eras/Blinds/Schematics/blinder.brd

## EAGLE design Schematics/blinder.brd (2012-12-26)

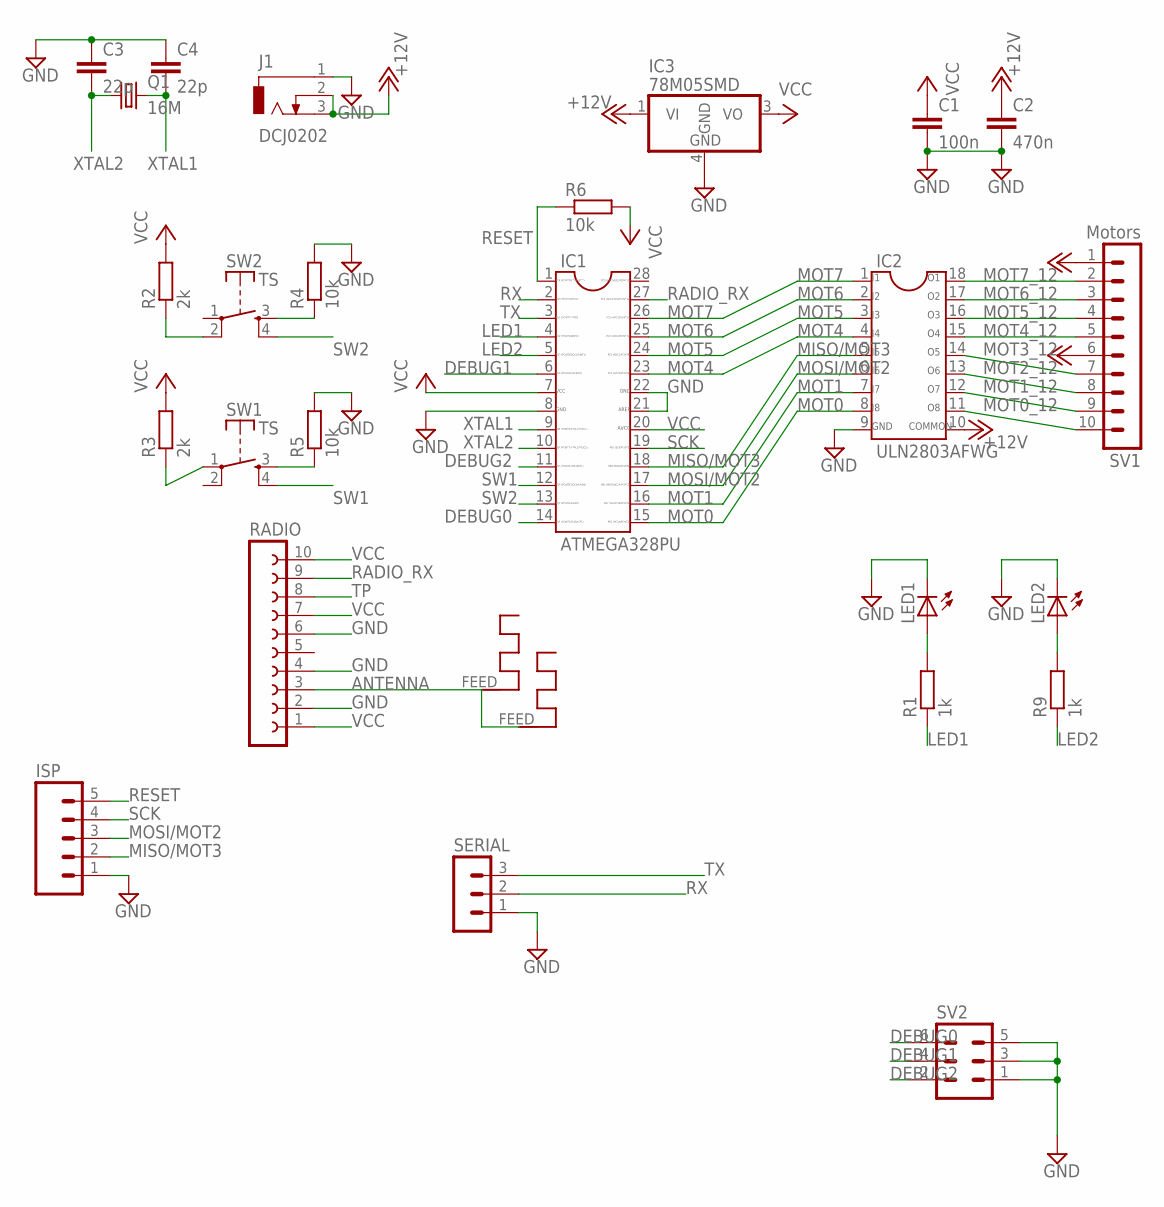
[picture p1: schematic blinder.sch]

Parts:
C1: 100n; C0805
C2: 470n; C0805
C3, C4: 22p; C0805
IC1: ATMEGA328PU; DIL28-3
IC2: ULN2803AFWG; DIL18
IC3: 78M05SMD; DPACK
ISP: M05LOCK; 1X05_LOCK
J1: DCJ0202
LED1, LED2: LED3MM
Q1: 16M; HC18U-V
R1, R9: 1k; R0805
R2, R3: 2k; R0805
R4, R5, R6: 10k; R0805
RADIO: FE10W
SERIAL: MA03-1
SV1: Motors; MA10-1W
SV2: MA03-2
SW1, SW2: TS
U$1, U$2: ANT44350H; DIPOLEHALF443.95_50

Connections:
+12V: C2.1, IC2.10 (COMMON), IC3.1 (VI), J1.2, J1.3, SV1.1, SV1.6
ANTENNA: RADIO.3, U$1.FEED, U$2.FEED
DEBUG0: IC1.14 (PB0), SV2.6
DEBUG1: IC1.6 (PD4), SV2.4
DEBUG2: IC1.11 (PD5), SV2.2
GND: C1.2, C2.2, C3.1, C4.1, IC1.8 (GND), IC1.21 (AREF), IC1.22 (GND2), IC2.9 (GND), IC3.4 (GND), ISP.1, J1.1, LED1.K (C), LED2.K (C), R4.2, R5.2, RADIO.2, RADIO.4, RADIO.6, SERIAL.1, SV2.1, SV2.3, SV2.5
LED1: IC1.4 (PD2), R1.1
LED2: IC1.5 (PD3), R9.1
MISO/MOT3: IC1.18 (PB4), IC2.5 (I5), ISP.2
MOSI/MOT2: IC1.17 (PB3), IC2.6 (I6), ISP.3
MOT0: IC1.15 (PB1), IC2.8 (I8)
MOT0_12: IC2.11 (O8), SV1.10
MOT1: IC1.16 (PB2), IC2.7 (I7)
MOT1_12: IC2.12 (O7), SV1.9
MOT2_12: IC2.13 (O6), SV1.8
MOT3_12: IC2.14 (O5), SV1.7
MOT4: IC1.23 (PC0), IC2.4 (I4)
MOT4_12: IC2.15 (O4), SV1.5
MOT5: IC1.24 (PC1), IC2.3 (I3)
MOT5_12: IC2.16 (O3), SV1.4
MOT6: IC1.25 (PC2), IC2.2 (I2)
MOT6_12: IC2.17 (O2), SV1.3
MOT7: IC1.26 (PC3), IC2.1 (I1)
MOT7_12: IC2.18 (O1), SV1.2
unnamed: LED1.A, R1.2
unnamed: LED2.A, R9.2
unnamed: R5.1, SW1.3 (S)
unnamed: R4.1, SW2.3 (S)
unnamed: R3.1, SW1.1
unnamed: R2.1, SW2.2
RADIO_RX: IC1.27 (PC4), RADIO.9
RESET: IC1.1 (PC6), ISP.5, R6.1
RX: IC1.2 (PD0), SERIAL.2
SCK: IC1.19 (PB5), ISP.4
SW1: IC1.12 (PD6), SW1.4 (S)
SW2: IC1.13 (PD7), SW2.4 (S)
TP: RADIO.8
TX: IC1.3 (PD1), SERIAL.3
VCC: C1.1, IC1.7 (VCC), IC1.20 (AVCC), IC3.3 (VO), R2.2, R3.2, R6.2, RADIO.1, RADIO.7, RADIO.10
XTAL1: C4.2, IC1.9 (PB6), Q1.2
XTAL2: C3.2, IC1.10 (PB7), Q1.1

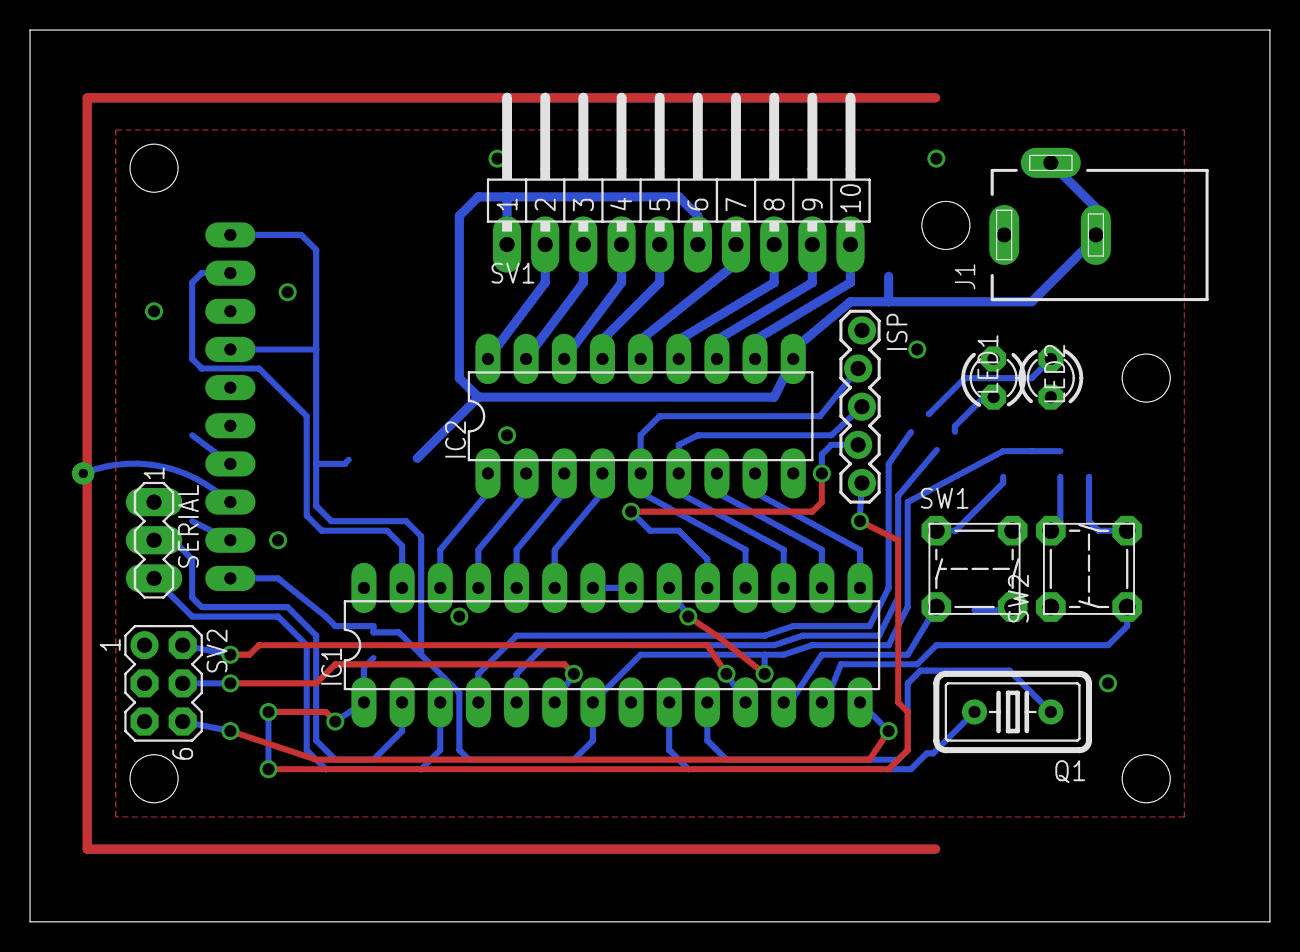
[picture p2: board blinder.brd from above]

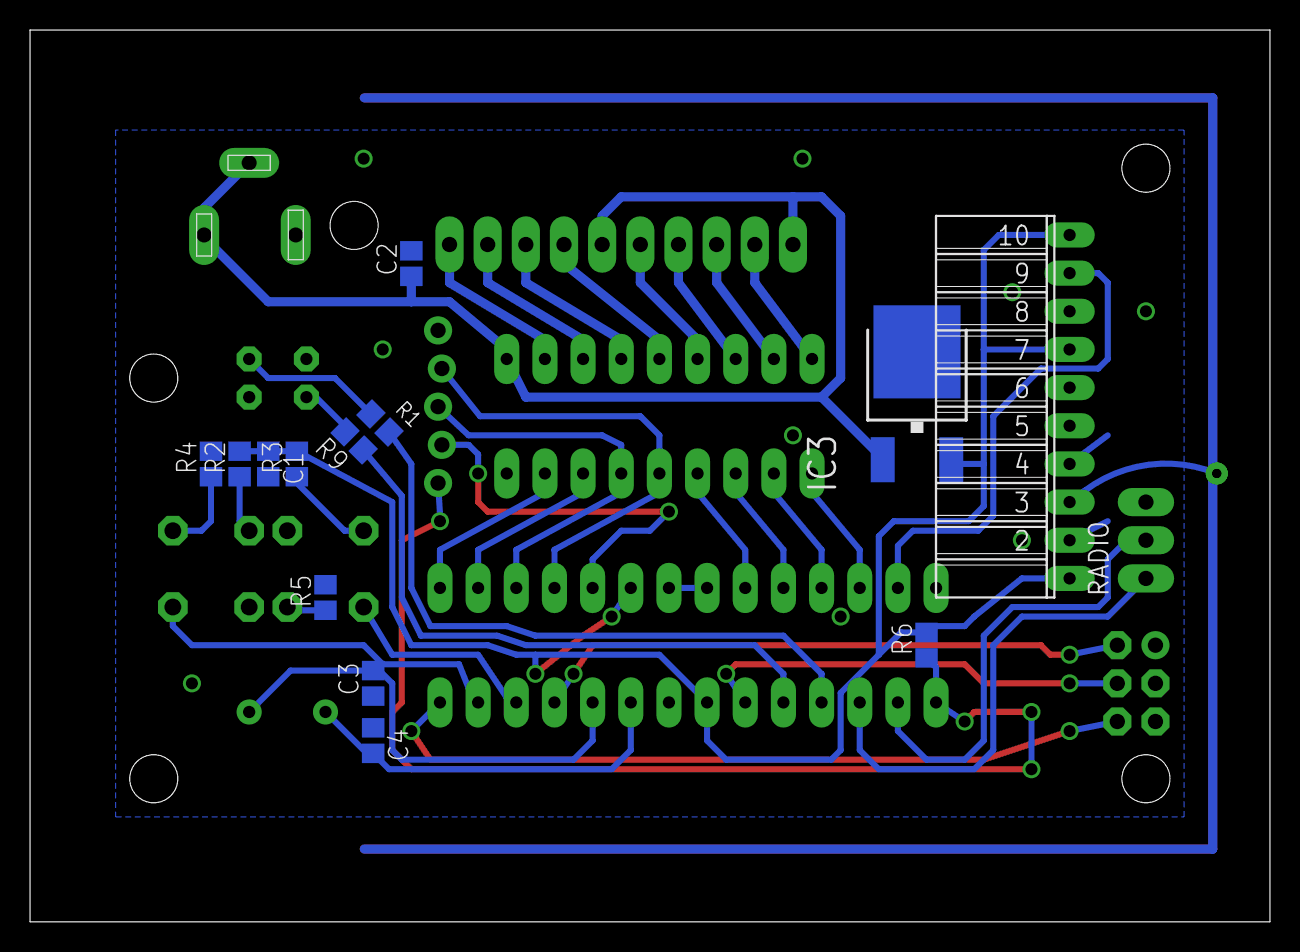
[picture p3: board blinder.brd from below]

Board: 2 copper layers, 82.5 x 59.4 mm, 27 parts (14 on the bottom side), 40 nets.
