eras/Blinds/(commit log)

2012-12-17 Control: motor control test
2012-12-18 Support for the two switches
2012-12-22 Direct port IO, faster
    But doesn't work the same. Doesn't work if xorring is added back. So
    the sequence is probably different. Logic analyzer?
    [Control.ino]
2012-12-22 powered: keep track if the motor is powered, and put it back to previous state when needed
2012-12-25 First iteration of interrupt-driven radio code
2012-12-25 NexaRx: Fully interrupt driven. In debug mode, 10 times slower than usual.
2012-12-25 NexaRX: actuall use with the radio clip with the correct speed
    [NexaRX.cpp]
2012-12-26 NexaRX: separate timerPreload and timerCycles; adjust TCNT1 by timerCycles in the ISR
2012-12-26 NexaRX: ignore the case when TCNT1 overruns during IO interrupt for now
2012-12-26 NexaTest: no need to disable interrupts for serial output
2012-12-26 Control.motor1_pins: reverse motor direction
    [Control.ino]
2012-12-26 Control.red/green_led_pin: provide these instead of plain 'led'
2012-12-26 Control: support for learning address when powered on with a switch depressed
2012-12-26 Schematics: added schematics
    [blinder.brd, blinder.sch]
